Breadstick-Innovations/Raspberry-Breadstick/(notices)

Notices in the files:
RP2040-Breadstick/RP2040-Breadstick.kicad_pcb:
Apache-2.0 License
